F97Crossbone/RF_Tracker/RF-Tracker/ShitboxV4_BOM.xls

Mouser # | Mfr. # | Order Qty. | Price (USD) | Ext.: (USD) | Ref | Manufacturer | Description
634-SI4010-C2-GS | SI4010-C2-GS | 1 | $5.24 | $5.24 | U1 | Silicon Laboratories | RF System on a Chip - SoC 8051 Sub-GHz RF transmitter
534-1025 | 1025 | 1 | $2.06 | $2.06 | BT1 | Keystone Electronics | Coin Cell Battery Holders COIN CELL HOLDER
603-RC0805FR-0710KL | RC0805FR-0710KL | 1 | $0.10 | $0.10 | R4 | YAGEO | Thick Film Resistors - SMD 10 kOhms 125 mW 0805 1%
710-150080VS75000 | 150080VS75000 | 1 | $0.19 | $0.19 | D2 | Wurth Elektronik | Standard LEDs - SMD WL-SMCW SMDMono TpVw Waterclr 0805 BrtGrn
710-150080RS75000 | 150080RS75000 | 1 | $0.19 | $0.19 | D1 | Wurth Elektronik | Standard LEDs - SMD WL-SMCW SMDMono TpVw Waterclr 0805 Red
710-150080YS75000 | 150080YS75000 | 1 | $0.19 | $0.19 | D3 | Wurth Elektronik | Standard LEDs - SMD WL-SMCW SMDMono TpVw Waterclr 0805 Yellow
611-PTS636SM25FSMTRL | PTS636 SM25F SMTR LFS | 1 | $0.18 | $0.18 | SW1 | C&K Switches | Tactile Switches Tact 50mA 12VDC, 6.0x3.5, 2.5mm H, 180gf, F leads, No ground pin, White Actuator
81-DFE201610E-1R0MP2 | DFE201610E-1R0M=P2 | 1 | $0.35 | $0.35 | L1 | Murata | Power Inductors - SMD 1.0 UH 2.7A
603-RC0805FR-071KL | RC0805FR-071KL | 3 | $0.10 | $0.30 | R1,R2,R3 | YAGEO | Thick Film Resistors - SMD 1 kOhms 125 mW 0805 1%
