F97Crossbone/RF_Tracker/RF-Tracker/Schematic/PTS636_SM25F_SMTR_LFS(1)/PTS636_SM25F_SMTR_LFS.step

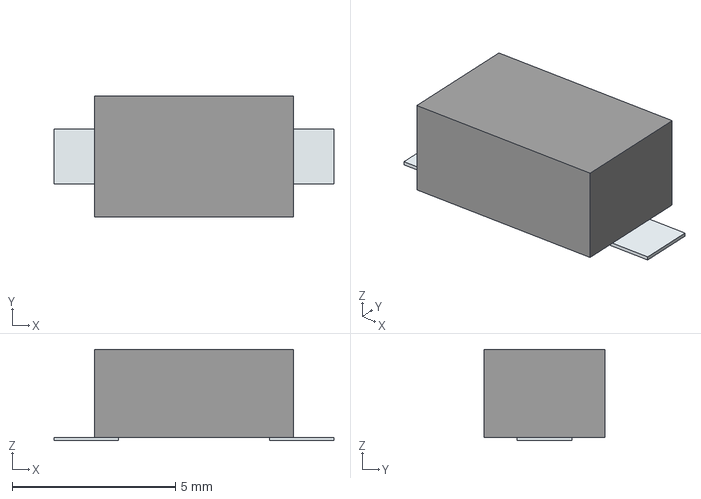
[picture p3: CAD file, 2023-02-22]
RF-Tracker/Schematic/PTS636_SM25F_SMTR_LFS(1)/PTS636_SM25F_SMTR_LFS.step
8.58 x 3.70 x 2.80 mm
Pins
