F97Crossbone/RF_Tracker/(list of files, cad)

Other CAD files:
RF-Tracker/common/src/si4010_link.OBJ
RF-Tracker/common/src/si4010_rom_keil.OBJ
RF-Tracker/common/src/si4010_data.OBJ
