F97Crossbone/RF_Tracker/RF-Tracker/Schematic/RFTransmitterV3.kicad_pcb

## KiCad design RF-Tracker/Schematic/RFTransmitterV3.kicad_pcb (2023-02-22)

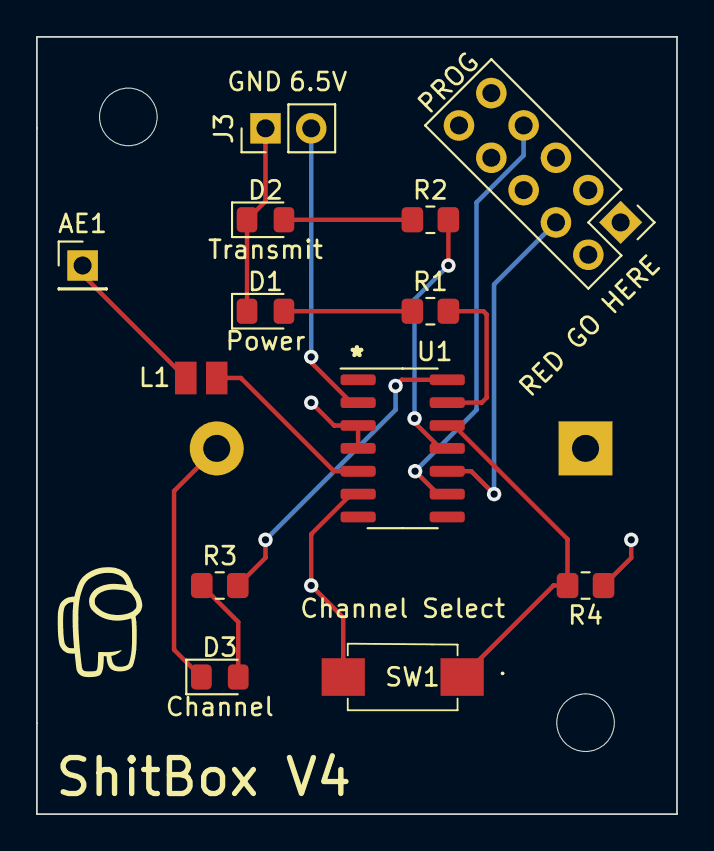
[picture p4: board RFTransmitterV3.kicad_pcb from above]

Board: 4 copper layers, 35.6 x 43.2 mm, 15 parts (1 on the bottom side), 14 nets.

Parts:
AE1: Antenna; PinHeader_1x01_P2.54mm_Vertical
BT1: 3.33v Coincell; BatteryHolder_Keystone_105_1x2430
D1: Power; LED_0805_2012Metric_Pad1.15x1.40mm_HandSolder
D2: Transmit; LED_0805_2012Metric_Pad1.15x1.40mm_HandSolder
D3: Channel; LED_0805_2012Metric_Pad1.15x1.40mm_HandSolder
G0: LOGO; amongus_small
J3: 6.5v Programming Connector; PinHeader_1x02_P2.54mm_Vertical
L1: 1uH; INDC2016X100N
PROG: ProgrammingAdapter; PinHeader_2x05_P2.54mm_Vertical
R1, R2, R3, R4: 1k; R_0805_2012Metric_Pad1.20x1.40mm_HandSolder
SW1: SW_ChnlSelect; PTS636SM25FSMTRLFS
U1: Si4010-GS; SOIC-14_3.9x8.7mm_P1.27mm

Connections:
+3V3: BT1.1 (+), SW1.2, U1.6
/C2CLK: PROG.7, U1.9
/C2DAT: PROG.4, U1.10
/TXP: L1.2, U1.5
/VPP: J3.2, U1.2
GND: BT1.2 (-), D1.1 (K), D2.1 (K), D3.1 (K), J3.1, PROG.2, R4.1, U1.3, U1.4
GPIO1: R1.2, U1.13
GPIO2: R4.2, SW1.1, U1.12
GPIO3: R2.2, U1.11
GPIO8: R3.2, U1.14
unnamed: AE1.1 (A), L1.1
unnamed: D1.2 (A), R1.1
unnamed: D2.2 (A), R2.1
unnamed: D3.2 (A), R3.1
