F97Crossbone/RF_Tracker/RF-Tracker/common/src/si4010_data.c

/*------------------------------------------------------------------------------
 *                          Silicon Laboratories, Inc.
 *                           http://www.silabs.com
 *                               Copyright 2010
 *------------------------------------------------------------------------------
 *
 *    FILE:       si4010_data.c
 *    TARGET:     Si4010
 *    TOOLCHAIN:  Generic
 *    DATE:       April 20, 2010, Tuesday
 *    RELEASE:    2.1 (JimG)
 *
 *------------------------------------------------------------------------------
 *
 *    DESCRIPTION:
 *      Definitions of global XDATA and XREG variables for Si4010
 *      at fixed XDATA locations. The file must be included
 *      in the project and linked with an application.
 *
 *------------------------------------------------------------------------------
 *
 *    INCLUDES:
 */
#define _SI4010_DATA_C
#include "si4010.h"

/*
 *------------------------------------------------------------------------------
 */
